ingenieriaam/antena_mifa/README.md

# Antena MIFA basada en diseño sobre ESP32
esp32 (https://www.espressif.com/en/products/socs/esp32)
Estudio y rediseño de la antena MIFA mediante simulaciones en CST Studio.

## en los archivos, ud encontrará:

| Archivo | Parametros |
| --- | --- |
| MIFA.cst | Antena según especificación del fabricante |
| MIFA_integration.cst | Antena con cotas accesorias para mayor comodidas en la variación de los parametros |
|AntenaMIFA_Gaete_Ortiz.pdf|Informe del trabajo realizado|

Accesoriamente, se facilita una presentación del trabajo accesible desde aqui:
https://ingenieriaam.github.io/antena_mifa/
Ante cualquier consulta, se invita al lector a recurrir a los issues de este repositorio y con gusto despejaremos sus dudas.

Atte:
- [Guillermo Gaete](isaacgaete@est.frba.utn.edu.ar)
- [Agustin Ortiz](aortiz@est.frba.utn.edu.ar)
